revk/ESP32-EPD/PCB/EPD154/README.md

# Epaper154

These files are for use in [KiCad](https://www.kicad.org).

## Trademark

This is an open source project, but bear in mind you cannot sell boards bearing the Andrews & Arnold Ltd name, the A&A logo, the registered trademark AJK logo, or the GS1 allocated EANs assigned to Andrews & Arnold Ltd.

## Images

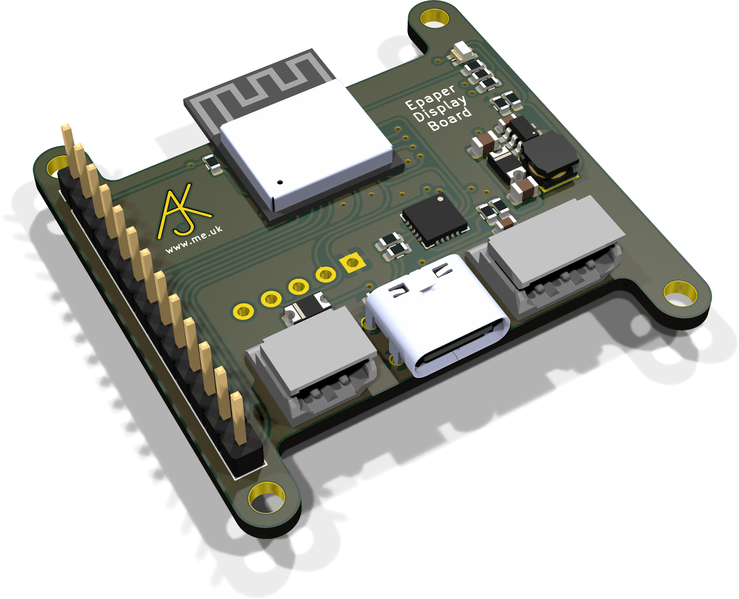
[picture p2: PCB/EPD154/Epaper154.png]
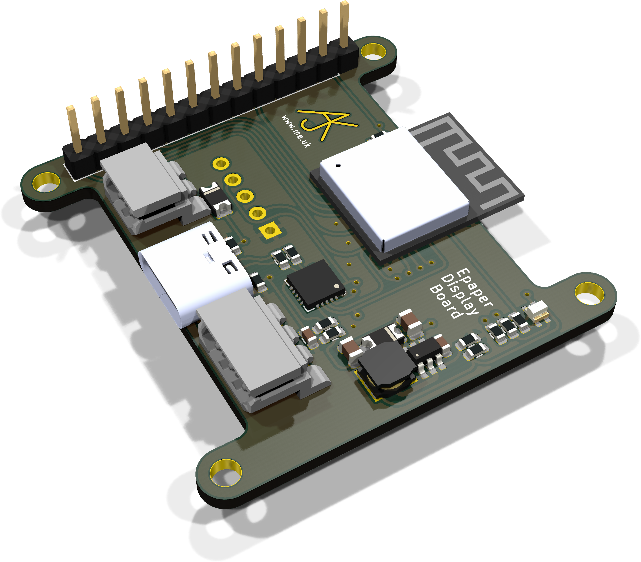
[picture p3: PCB/EPD154/Epaper154-90.png]
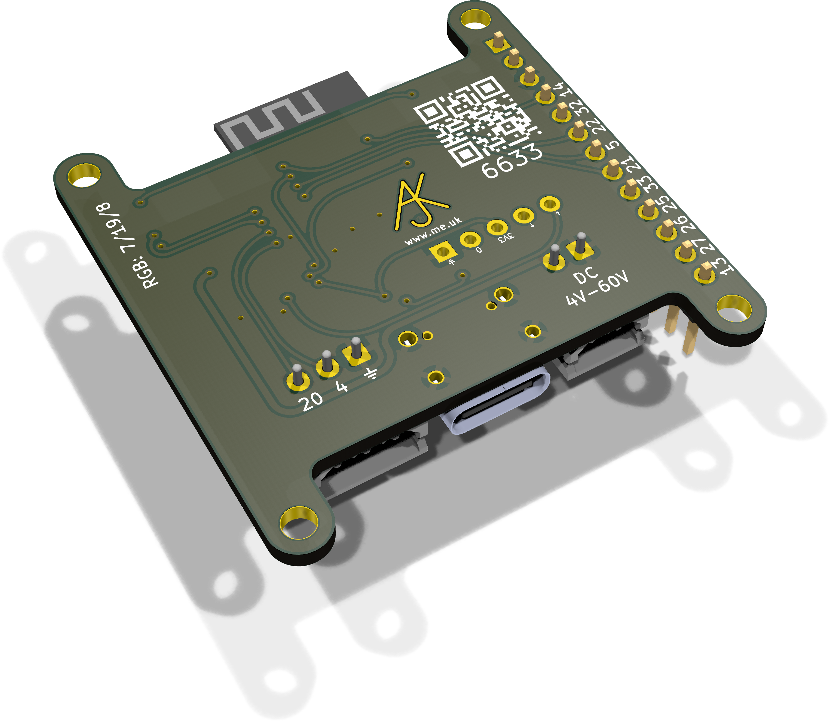
[picture p4: PCB/EPD154/Epaper154-bottom.png]
