revk/ESP32-EPD/PCB/EPD213/README.md

# Epaper213

These files are for use in [KiCad](https://www.kicad.org).

## Trademark

This is an open source project, but bear in mind you cannot sell boards bearing the Andrews & Arnold Ltd name, the A&A logo, the registered trademark AJK logo, or the GS1 allocated EANs assigned to Andrews & Arnold Ltd.

## Images

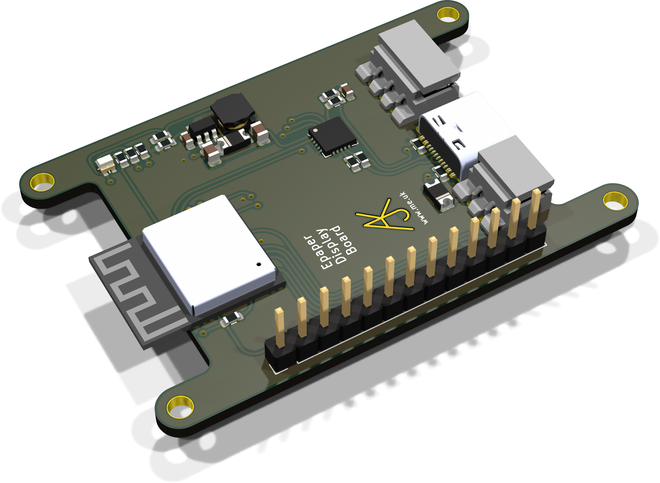
[picture p5: PCB/EPD213/Epaper213.png]
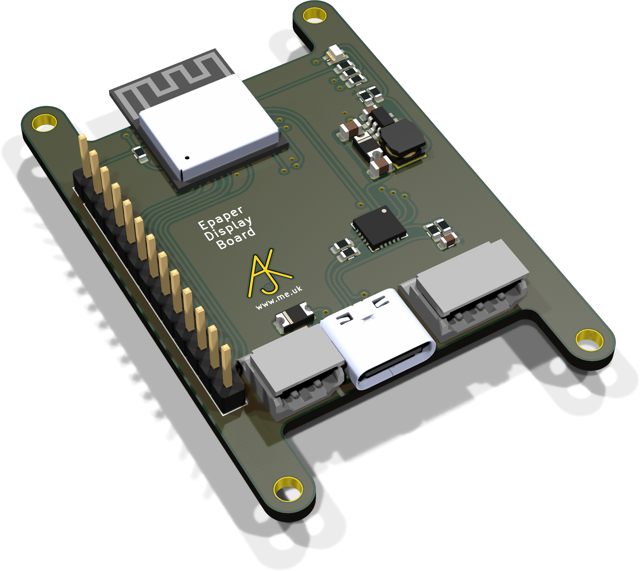
[picture p6: PCB/EPD213/Epaper213-90.png]
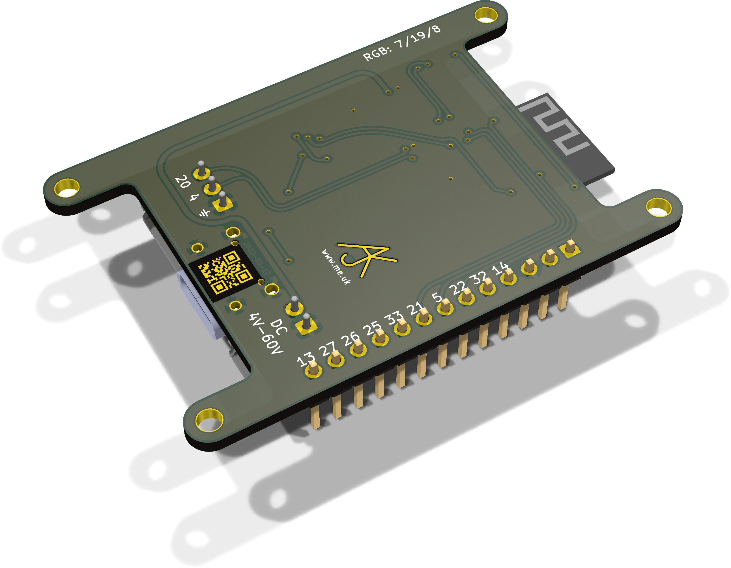
[picture p7: PCB/EPD213/Epaper213-bottom.png]
