revk/ESP32-EPD/PCB/EPD75/README.md

# EPD75

These files are for use in [KiCad](https://www.kicad.org).

## Trademark

This is an open source project, but bear in mind you cannot sell boards bearing the Andrews & Arnold Ltd name, the A&A logo, the registered trademark AJK logo, or the GS1 allocated EANs assigned to Andrews & Arnold Ltd.

## Images

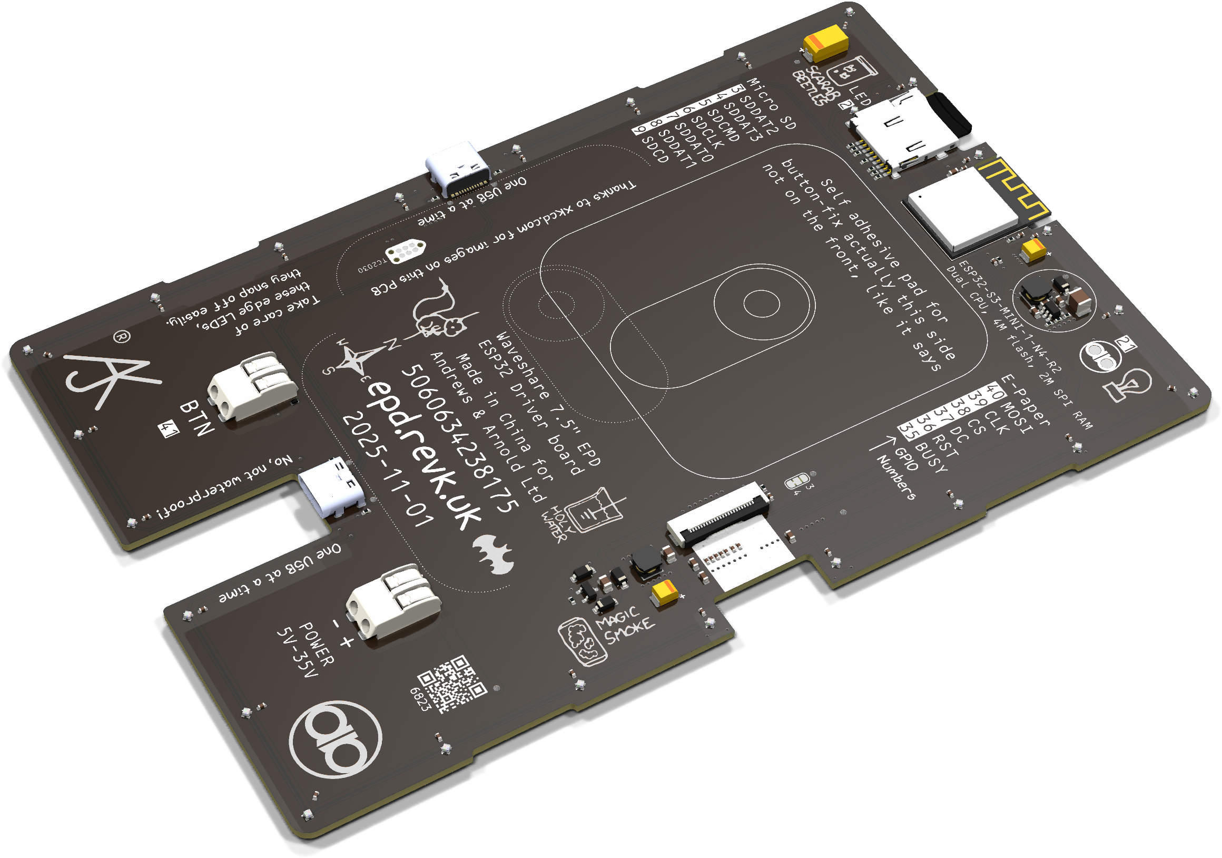
[picture p8: PCB/EPD75/EPD75-90.png]
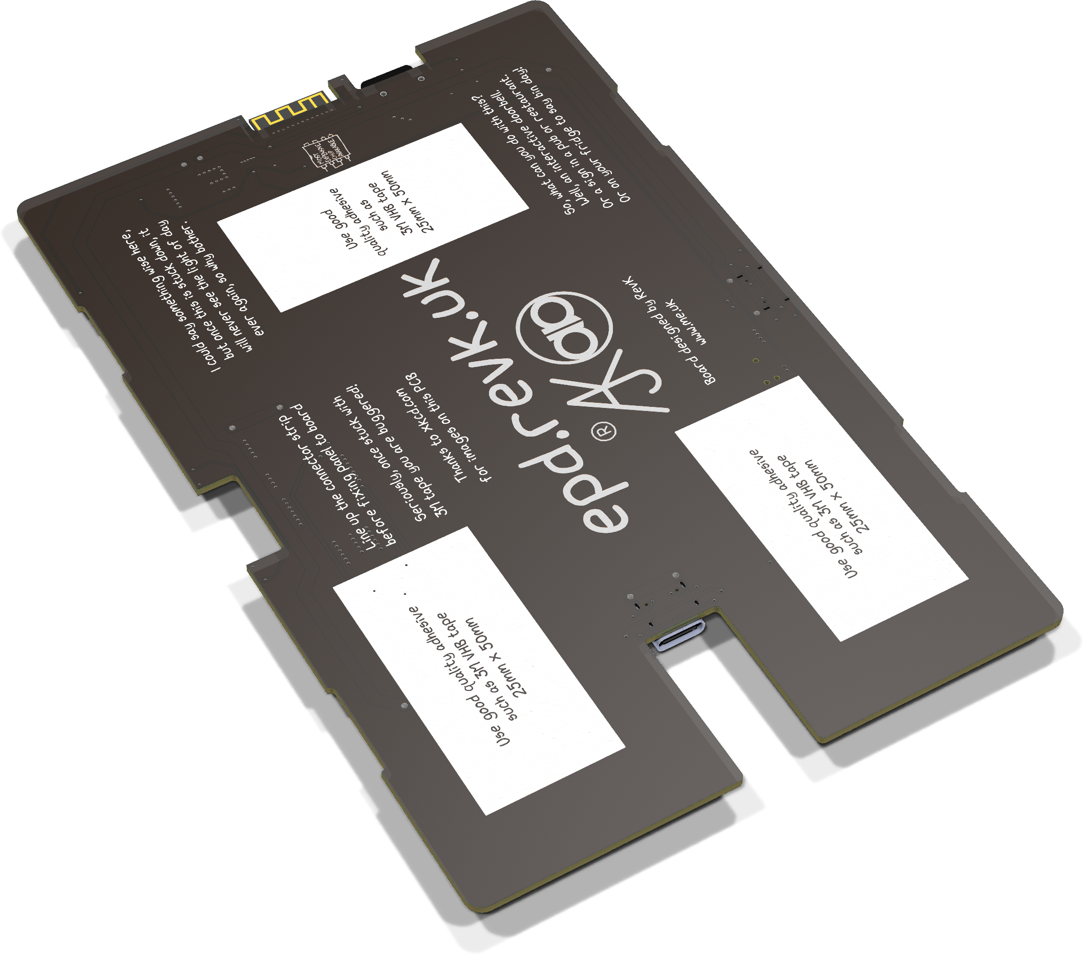
[picture p9: PCB/EPD75/EPD75-bottom.png]
