revk/ESP32-EPD/PCB/EPDBat/README.md

# EPDBat

These files are for use in [KiCad](https://www.kicad.org).

## Trademark

This is an open source project, but bear in mind you cannot sell boards bearing the Andrews & Arnold Ltd name, the A&A logo, the registered trademark AJK logo, or the GS1 allocated EANs assigned to Andrews & Arnold Ltd.

## Images

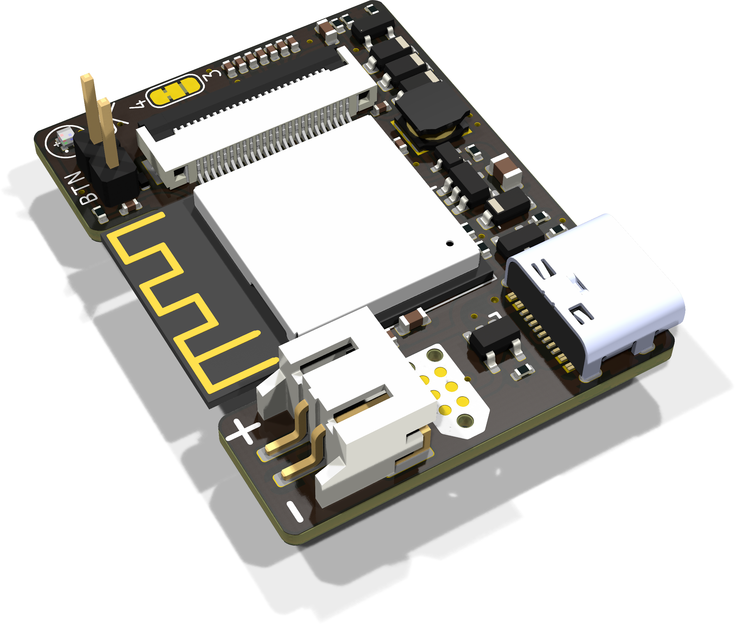
[picture p10: PCB/EPDBat/EPDBat.png]
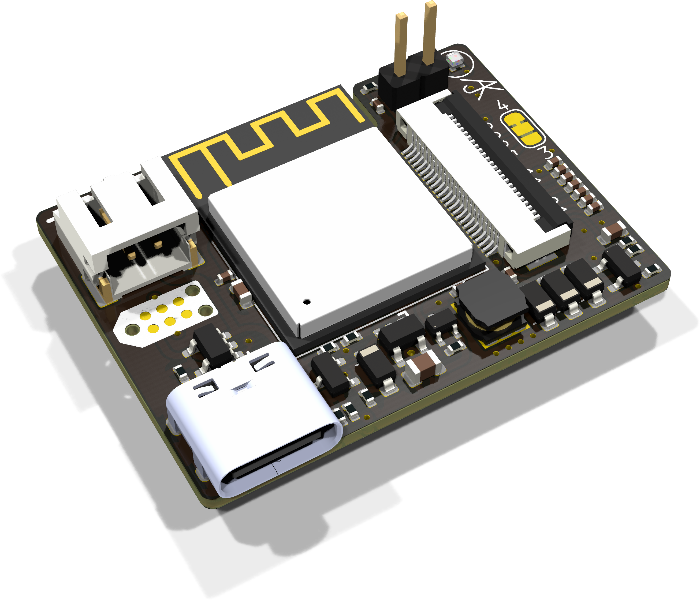
[picture p11: PCB/EPDBat/EPDBat-90.png]
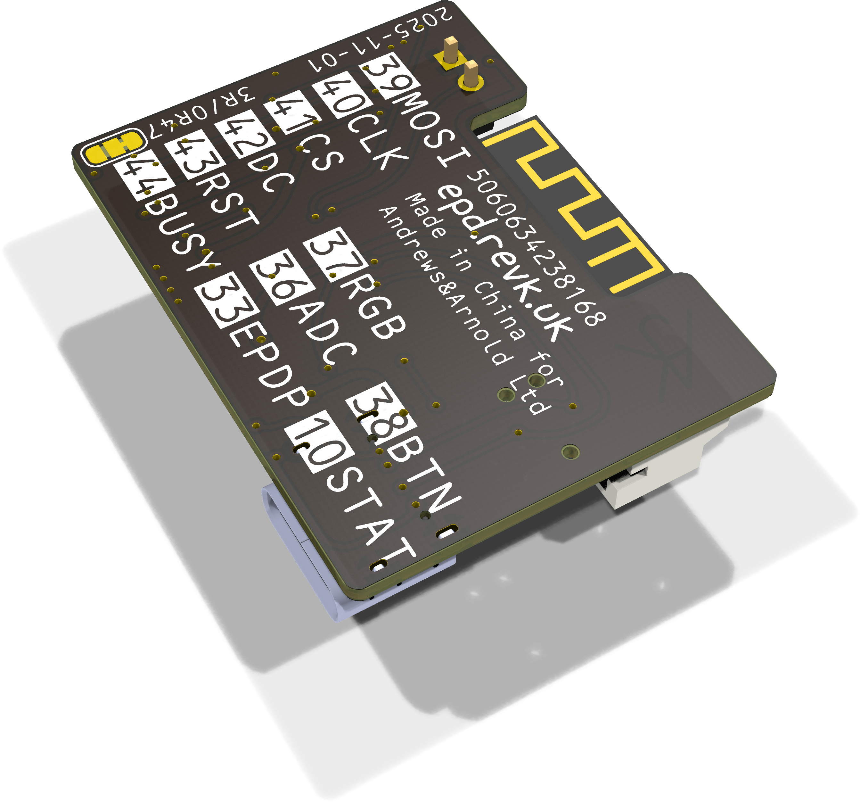
[picture p12: PCB/EPDBat/EPDBat-bottom.png]

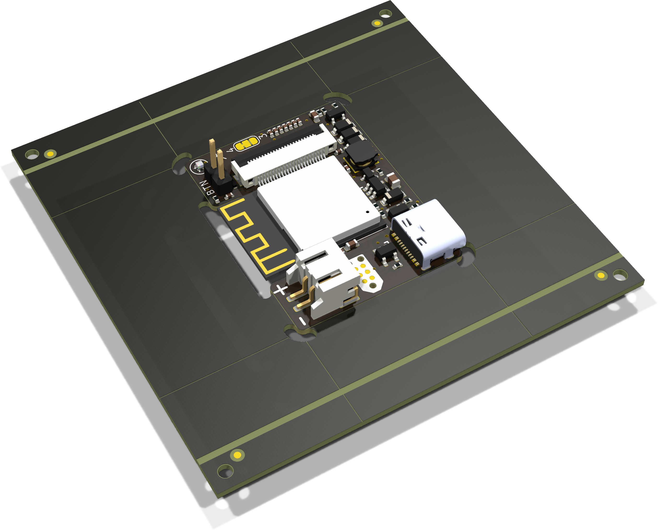
[picture p13: PCB/EPDBat/EPDBat-panel.png]
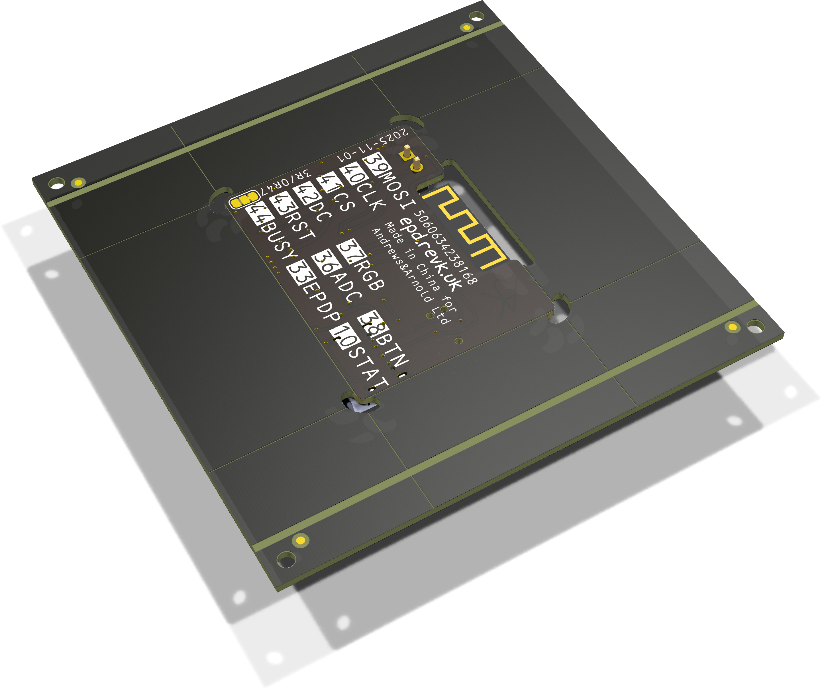
[picture p14: PCB/EPDBat/EPDBat-panel-bottom.png]
