revk/ESP32-EPD/PCB/EPD75NFC/EPD75-90.png

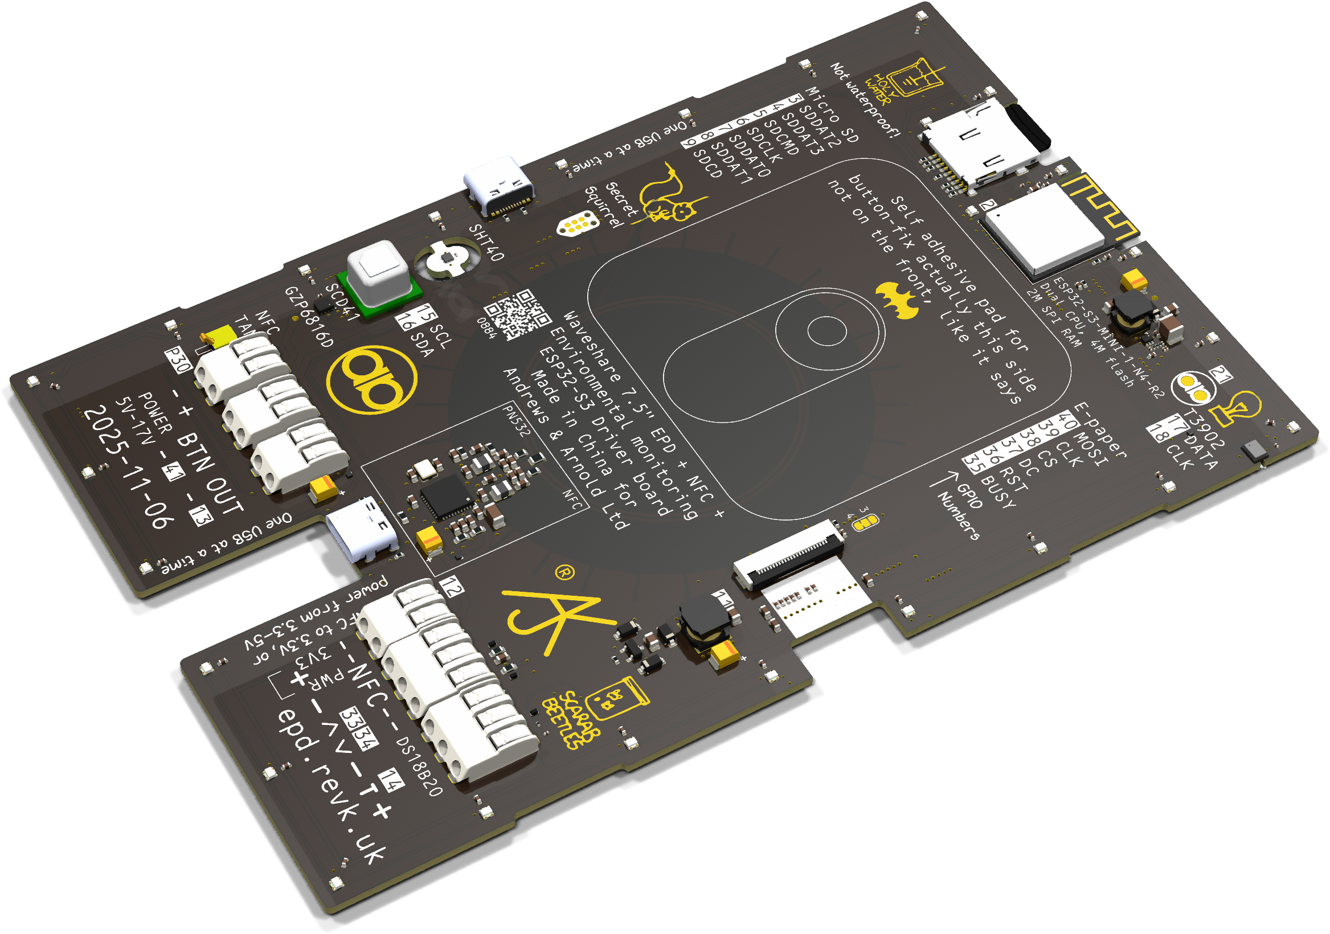
PCB/EPD75NFC/EPD75-90.png
