revk/ESP32-EPD/PCB/EPD75NFC/EPD75.png

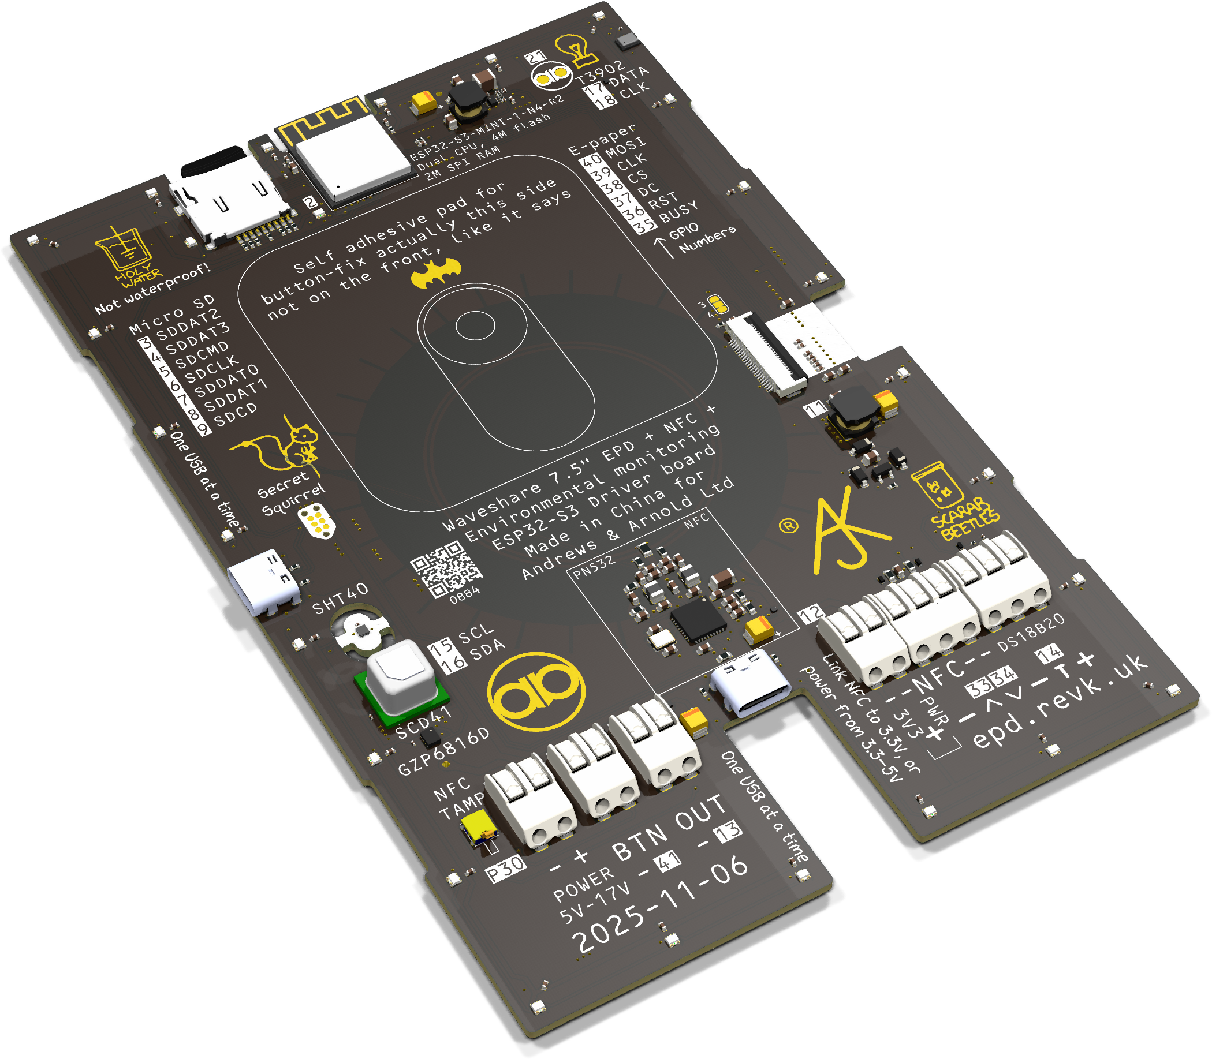
PCB/EPD75NFC/EPD75.png
