revk/ESP32-EPD/PCB/EPD/EPD-90.png

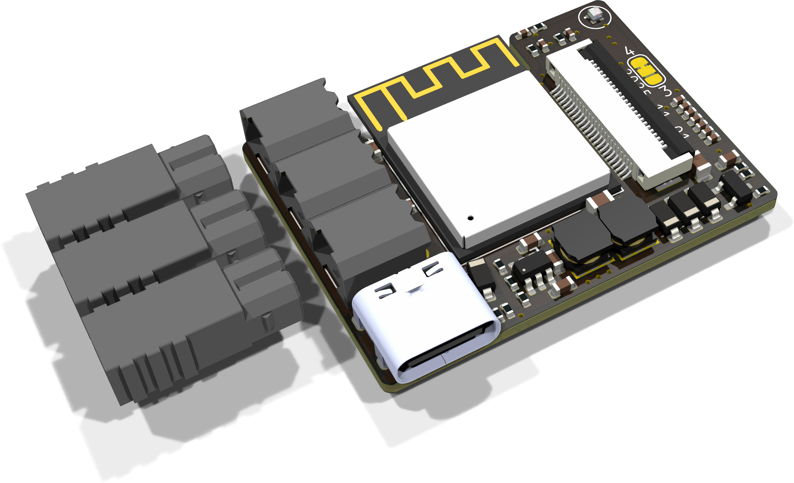
PCB/EPD/EPD-90.png
