revk/ESP32-EPD/PCB/EPD/EPD-bottom.png

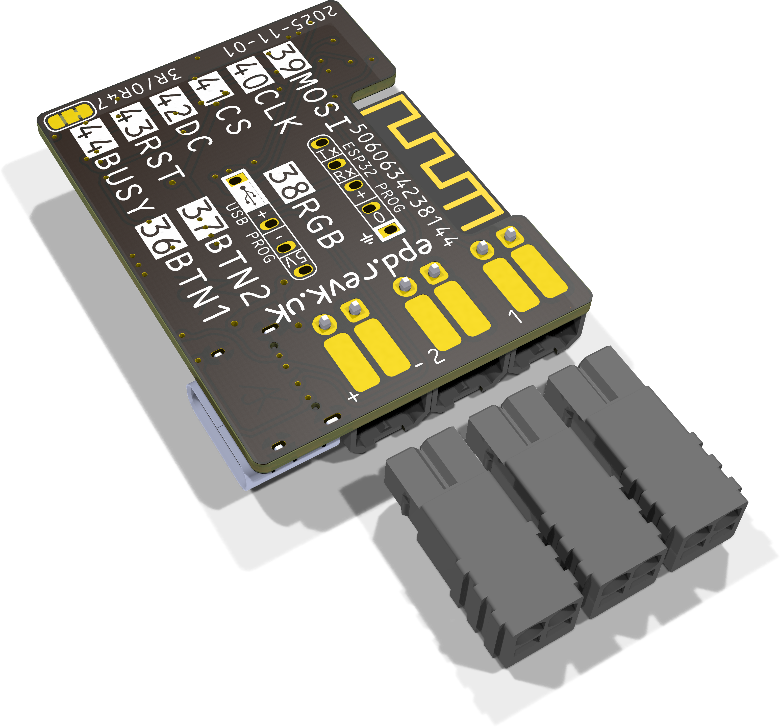
PCB/EPD/EPD-bottom.png
