revk/ESP32-EPD/PCB/EPD/EPD-panel-bottom.png

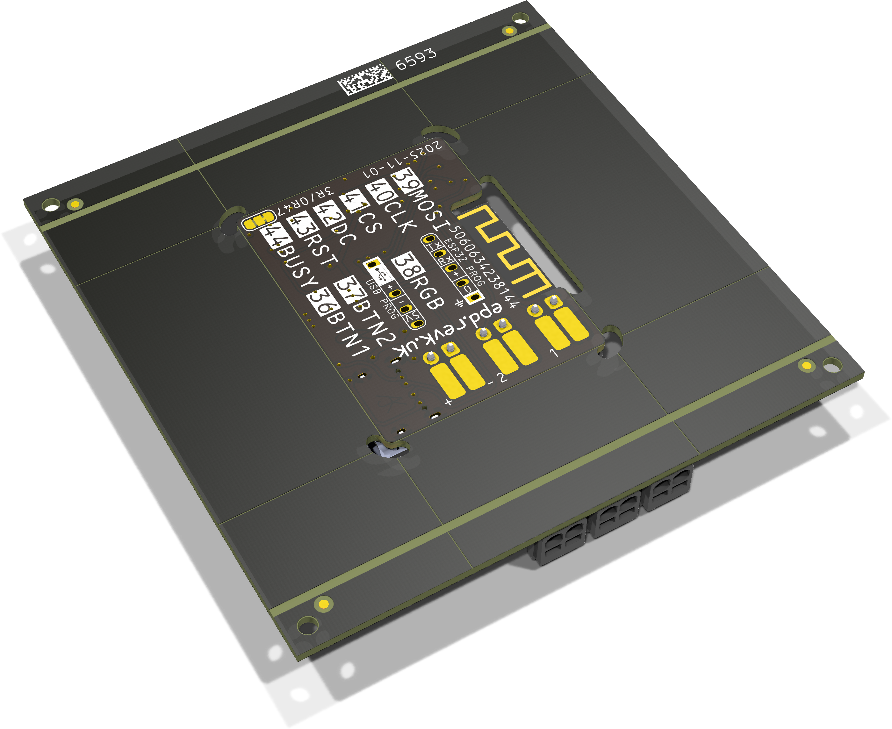
PCB/EPD/EPD-panel-bottom.png
