revk/ESP32-EPD/PCB/EPD/EPD-panel.png

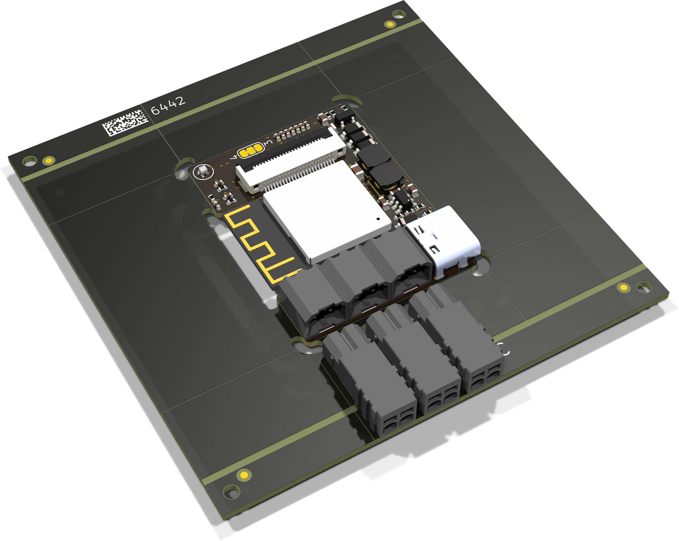
PCB/EPD/EPD-panel.png
