revk/ESP32-EPD/PCB/EPD/EPD.png

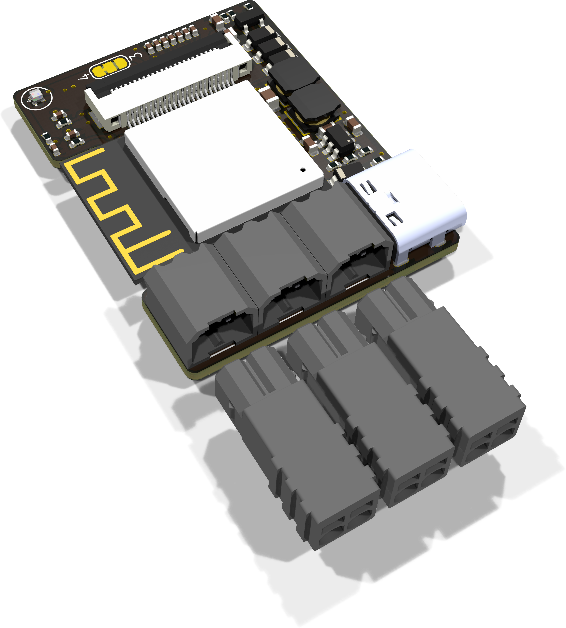
PCB/EPD/EPD.png
