revk/ESP32-EPD/PCB/EPD/EPD.stl

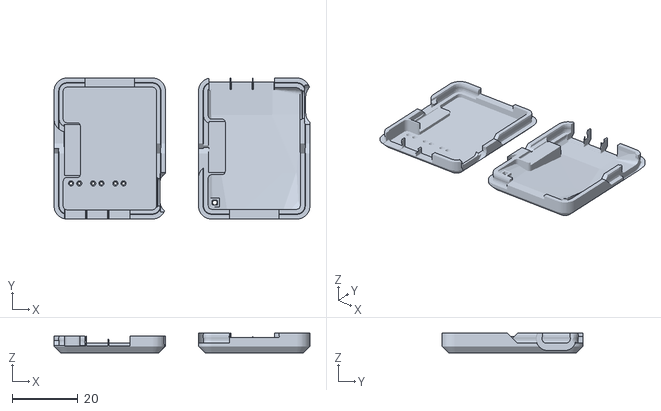
[picture p22: CAD file, 2025-11-01]
PCB/EPD/EPD.stl
78.0 x 43.0 x 5.99
