revk/ESP32-EPD/PCB/EPD75/Backbox.FCStd

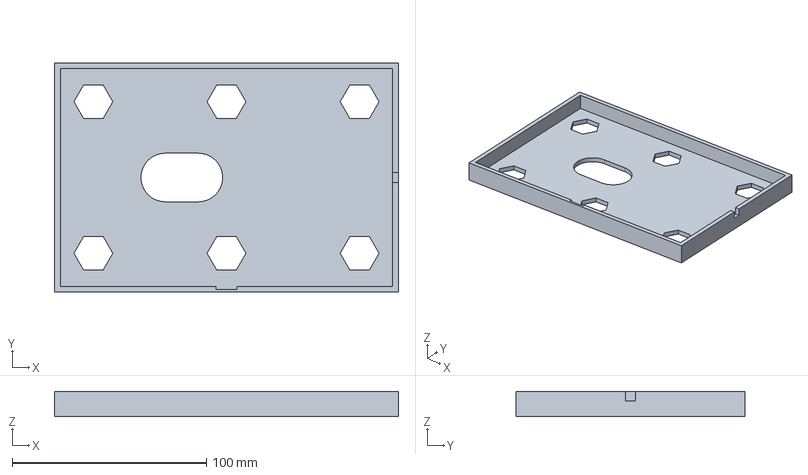
[picture p23: CAD file, 2025-03-20]
PCB/EPD75/Backbox.FCStd
177.0 x 118.0 x 13.0 mm
