revk/ESP32-EPD/PCB/EPDBat/EPDBat.stl

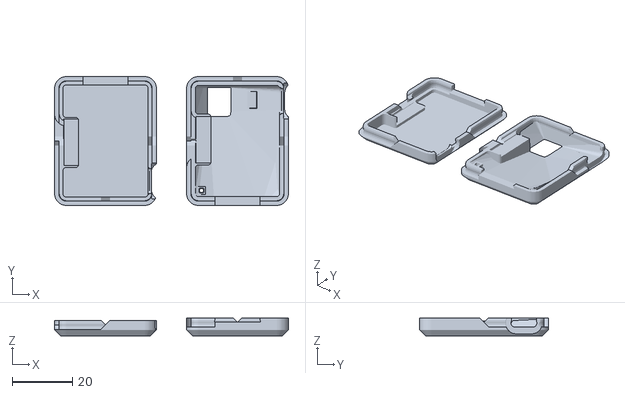
[picture p24: CAD file, 2025-11-01]
PCB/EPDBat/EPDBat.stl
78.0 x 43.0 x 5.99
