revk/ESP32-EPD/(list of files, cad)

Other CAD files:
PCB/EPD75/Backbox-BodyPocket002.stl
PCB/EPDBat/EPDBat.scad
