revk/ESP32-EPD/(threads)

Thread 1 (2025-03-01):

Ability to interact with mqtt

TonyHoyle, 2025-03-01:
It would be nice if you could set widgets using mqtt, then I could feed it mqtt data from things like homeassistant.   It would seem to be sensible to do it publishing a setting eg. settings/F0F5BD731DF8 {"widgetc3":"foo"}

revk, 2025-03-01:
Err, all widget settings can be done via MQTT just like that, what am I missing?

TonyHoyle, 2025-03-01:
I tried and nothing happens.  Normal commands like reboot work.  If it's supposed to work already I'll keep trying things, maybe doing something wrong.

(Another thing I discovered just now that the $IPV4 command always shows 192.168.4.1, which isn't even the same subnet that it's sitting on.. (it's actually on 	192.168.10.151)).

revk, 2025-03-01:
Ok I'll look in morning

revk, 2025-03-01:
oooh wait, `setting` or `settings`?

TonyHoyle, 2025-03-01:
Oh that may be it..

TonyHoyle, 2025-03-02:
Got it working.. seems pretty responsive.

At the risk of overloading this ssue still further, Is landscape mode possible?  I tried flipping the bit in gfxflip but it stopped it displaying anything at all..

revk, 2025-03-02:
Gfxflip should allow landscape, but not tested for a while. I'll have to check.

I am still trying to make the fast update better contrast. Been battling all week.

revk, 2025-03-02:
Just tried here, and nothing shows, so will test and fix when not at the pub.

Bit 2 (value 4) is x/y swap. Set for portrait as panel is actually 800x480. So flips OK, just does not unflip!!!

revk, 2025-03-02:
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

Ok fixed it whilst at the pub. The GFX code was fine. The EPD code was trying to plot a QR on remaining space on the startup page that was 4.2 billion pixels high ish. So would, one day, have shown something.

Try latest beta.

TonyHoyle, 2025-03-02:
That would be need pretty high resolution display 📦

TonyHoyle, 2025-03-02:
Heh.. lost all the positioning information when I upgraded.. but since I was going to switch to landscape anyway, no loss I guess.  Seems to work so far.

revk, 2025-03-02:
Yeh, sorry, my bad on that.

Glad it is working.

revk, 2025-03-27:
Ok new features since, hope all is OK.

Did you see https://www.revk.uk/2025/03/more-on-e-paper.html ? If you want me to send a 470uH inductor, let me know.

TonyHoyle, 2025-03-27:
I could probably use one.. my screen looks fairly ropey after I rearranged the output and all the old positions stuck.

revk, 2025-03-28:
I'll post you one - slightly fiddly to replace - don't heat hun your panel! It is the inductor near the e-paper connector (by a bat probably).

Closed 2025-03-27.

Thread 3 (2025-06-05):

Can't get bins widget to show individual collection info

jshholland, 2025-06-05:
I've been trying to set up the bin widget to show collections for my local council. I wrote some code to scrape their website (stealing the flow from the [UKBinCollectionData](https://github.com/robbrad/UKBinCollectionData/) repo) and reformat it to how the display expects to receive it. It's clearly partially working, as I can see requests arriving and it shows the correct day on the screen, but I can't get it to show which bins are due to be collected:

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

I've tried a few different formats for the response (and it initially caught me out that putting `http://ip:port/api/bins` into the URL textarea resulted in requests to `/api/bins.json`) but none have worked. I even got as far as hardcoding the sample JSON from the readme as the response, but that has the same (lack of) effect.

Here's what my code response looks like:

```json
{"collect":"2025-06-10 07:00:00","baseurl":"http://<ip>:4000","bins":[{"name":"Domestic Waste","icon":"/general.png"}]}
```

It's definitely doing something to parse the "bins" field as when I was testing it I got it to turn on the LED that way (although I don't want to use the LEDs for this once it's working properly). It is also sometimes showing the "name" field but I haven't been able to work out what is and isn't working.

I've tried: icon as `general.png`, `/general.png`, `http://<ip>:4000/general.png`, `/general`, with and without the `collect` field, and with and without a final `{}`.

I'd also be keen to get tips for how to debug this a bit more easily than changing random things and rebooting it to see what appears on the screen - I tried messing around with platformio but it seems like serious overkill just to see some of the ESP_LOGD outputs, but I really am not an expert on this sort of embedded development.

revk, 2025-06-06:
The way to get debug is installing ESP IDF and running `idf.py monitor` on the USB port, that should help show if issues accessing PNG URLs, etc. I could add some levels of additional MQTT logging.

I'll see if I can test using ip:port format, but I would expect that to work to be honest.

revk, 2025-06-06:
OK, weird...

I am getting

```
E (15490) esp-tls: [sock=60] delayed connect error: Connection reset by peer
E (15491) transport_base: Failed to open a new connection: 32772
E (15494) HTTP_CLIENT: Connection failed, sock < 0
E (15499) EPD: Failed http client open http://91.240.176.1:4000//general.png
```

Which suggests that it is trying TLS?! Looking in to it.

revk, 2025-06-06:
OK the TLS may be a red herring, it *is* trying to get to port 4000. So let me try serving something.

Now I see

```
E (15381) EPD: Unknown http://91.240.176.252:4000/general.png error Not a PNG Bad JSON
```

With my apache confirming it responded 404.

So I have actually set up a png, and served that and it shows.

Maybe check your server logs?

I removed the initial `/` from the icon, but my apache serves fine with it present.

jshholland, 2025-06-06:
It's nothing fancy, just something from Flaticons.com that I resized with ImageMagick. But here it is:

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

Also uploaded to [0x0.st](https://0x0.st/8gMh.png) in case GitHub mangles it somehow

jshholland, 2025-06-06:
Huh, why does it show up OK with the image widget then? Does that have some auto-invert logic?

jshholland, 2025-06-06:
Great, now I have an image that displays properly I am happy it's all working! Thanks a lot.

revk, 2025-06-06:
Thanks, sorry for confusion, and not the explanation I expected...

Closed 2025-06-06.
