revk/ESP32-EPD/PCB/EPD75/EPD75.kicad_pcb

## KiCad design PCB/EPD75/EPD75.kicad_pcb (2025-09-28)

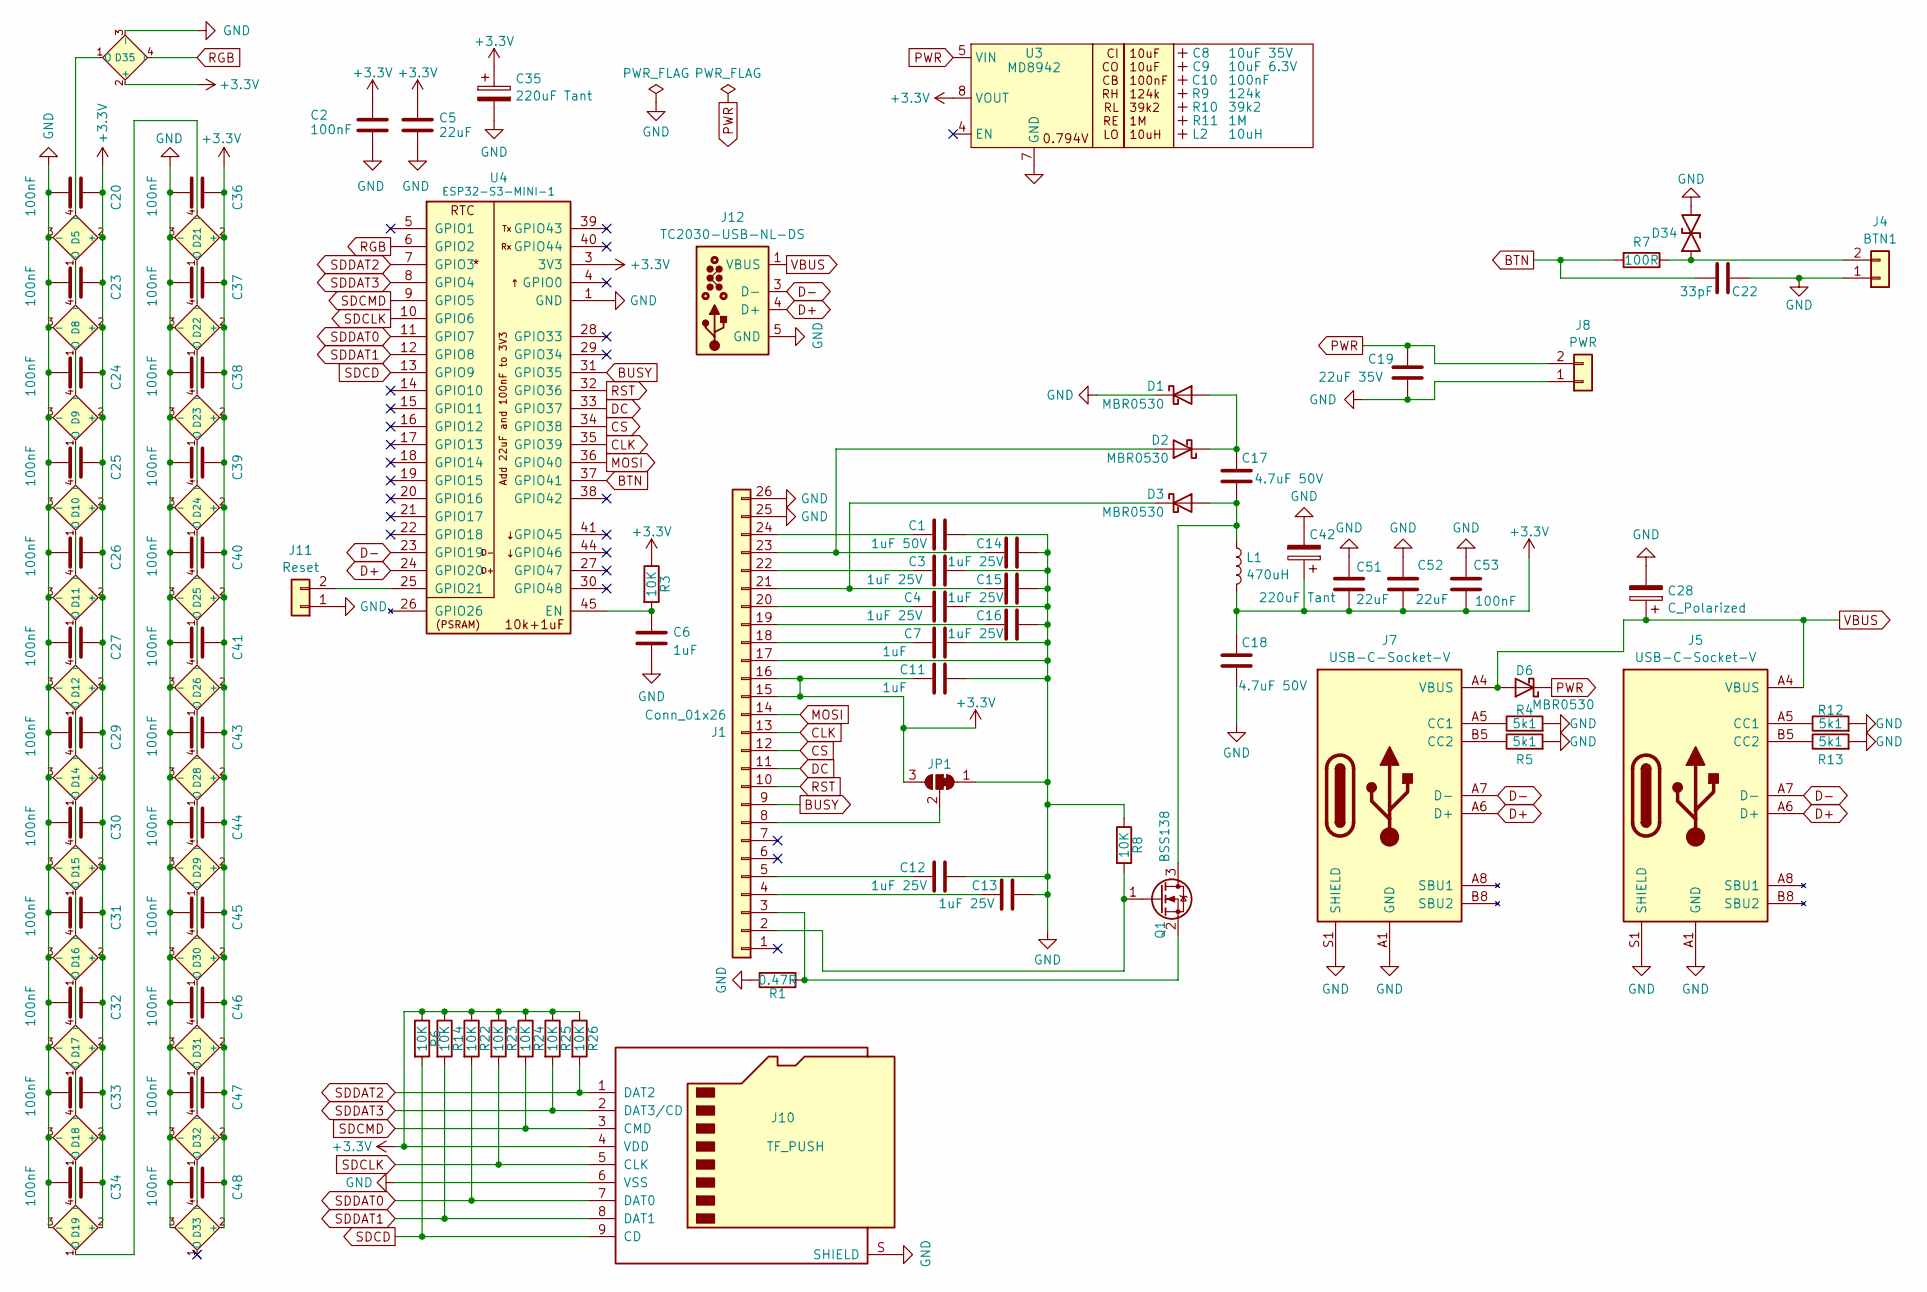
[picture p25: schematic EPD75.kicad_sch, E-Paper 7.5"]

Parts:
C1: 1uF 50V; C_0603
C2, C20, C23, C24, C25, C26, C27, C29, C30, C31, C32, C33, C34, C36, C37, C38, C39, C40, C41, C43, C44, C45, C46, C47, C48, C53: 100nF; C_0402
C3, C4, C12, C13, C14, C15, C16: 1uF 25V; C_0402
C5, C51, C52: 22uF; C_0603
C6, C7, C11: 1uF; C_0402
C8: 10uF 35V; C_0603_; MPN C194427
C9: 10uF 6.3V; C_0603_; MPN C1691
C10: 100nF; C_0603_
C17, C18: 4.7uF 50V; C_0805
C19: 22uF 35V; C_1210
C22: 33pF; C_0402
C28: C_Polarized; CP_EIA-7343-31_Kemet-D; MPN C106188
C35, C42: 220uF Tant; CP_EIA-3528-21_Kemet-B; MPN C122649
D1, D2, D3, D6: MBR0530; D_SOD-123; MPN C5204746
D5, D8, D9, D10, D11, D12, D14, D15, D16, D17, D18, D19, D21, D22, D23, D24, D25, D26, D28, D29, D30, D31, D32, D33, D35: XL-1010RGBC-WS2812B; MPN C5349953
D34: DFN1006-2L; MPN C5137770
J1: Conn_01x26; XUNPU-FPC-05FB-24PH20; MPN C2856831
J4: BTN1; WAGO-2060-452-998-404; MPN C2765055
J5, J7: USB-C-Socket-V; USB-C-Socket-H; MPN C709357
J8: PWR; WAGO-2060-452-998-404; MPN C2765055
J10: TF_PUSH; MPN C393941
J11: Reset; AA-Pad
J12: TC2030-USB-NL-DS; Tag-Connect_TC2030-IDC-NL_2x03_P1.27mm_Vertical
JP1: SolderJumper_3_Bridged12; SolderJumper3
L1: 470uH; L_4x4; MPN C42429207
L2: 10uH; L_4x4_; MPN C167879
Q1: BSS138; SOT-23; MPN C2938375
R1: 0.47R; R_0402; MPN C2771738
R3, R6, R8, R14, R22, R23, R24, R25, R26: 10K; R_0402
R4, R5, R12, R13: 5k1; R_0402
R7: 100R; R_0402
R9: 124k; R_0402_; MPN C138062
R10: 39k2; R_0402_
R11: 1M; R_0402_
U3: MD8942; SOT-23-6-MD8942; MPN C2684786
U4: ESP32-S3-MINI-1; MPN C3013941

Connections:
+3.3V: C2.1, C5.1, C11.1, C18.2, C20.1, C23.1, C24.1, C25.1, C26.1, C27.1, C29.1, C30.1, C31.1, C32.1, C33.1, C34.1, C35.1, C36.1, C37.1, C38.1, C39.1, C40.1, C41.1, C42.1, C43.1, C44.1, C45.1, C46.1, C47.1, C48.1, C51.2, C52.2, C53.2, D5.2 (+), D8.2 (+), D9.2 (+), D10.2 (+), D11.2 (+), D12.2 (+), D14.2 (+), D15.2 (+), D16.2 (+), D17.2 (+), D18.2 (+), D19.2 (+), D21.2 (+), D22.2 (+), D23.2 (+), D24.2 (+), D25.2 (+), D26.2 (+), D28.2 (+), D29.2 (+), D30.2 (+), D31.2 (+), D32.2 (+), D33.2 (+), D35.2 (+), J1.15, J1.16, J10.4 (VDD), JP1.3 (B), L1.2, R3.1, R6.1, R14.1, R22.1, R23.1, R24.1, R25.1, R26.1, U3.8 (VOUT), U4.3 (3V3)
BTN: C22.1, R7.2, U4.37 (GPIO41)
BUSY: J1.9, U4.31 (GPIO35)
CLK: J1.13, U4.35 (GPIO39)
CS: J1.12, U4.34 (GPIO38)
D+: J5.A6 (D+), J5.B6 (D+), J7.A6 (D+), J7.B6 (D+), J12.4 (D+), U4.24 (GPIO20)
D-: J5.A7 (D-), J5.B7 (D-), J7.A7 (D-), J7.B7 (D-), J12.2 (NC), J12.3 (D-), J12.6 (NC), U4.23 (GPIO19)
DC: J1.11, U4.33 (GPIO37)
GND: C1.2, C2.2, C3.2, C4.2, C5.2, C6.2, C7.2, C11.2, C12.2, C14.2, C15.2, C18.1, C19.2, C20.2, C22.2, C23.2, C24.2, C25.2, C26.2, C27.2, C28.2, C29.2, C30.2, C31.2, C32.2, C33.2, C34.2, C35.2, C36.2, C37.2, C38.2, C39.2, C40.2, C41.2, C42.2, C43.2, C44.2, C45.2, C46.2, C47.2, C48.2, C51.1, C52.1, C53.1, D1.1 (K), D5.3 (-), D8.3 (-), D9.3 (-), D10.3 (-), D11.3 (-), D12.3 (-), D14.3 (-), D15.3 (-), D16.3 (-), D17.3 (-), D18.3 (-), D19.3 (-), D21.3 (-), D22.3 (-), D23.3 (-), D24.3 (-), D25.3 (-), D26.3 (-), D28.3 (-), D29.3 (-), D30.3 (-), D31.3 (-), D32.3 (-), D33.3 (-), D34.1, D35.3 (-), J1.17, J1.25, J1.26, J4.1, J5.A1 (GND), J5.A12 (GND), J5.B1 (GND), J5.B12 (GND), J5.S1 (SHIELD), J7.A1 (GND), J7.A12 (GND), J7.B1 (GND), J7.B12 (GND), J7.S1 (SHIELD), J8.1, J10.6 (VSS), J10.S (SHIELD), J11.1, J12.5 (GND), JP1.1 (A), R1.2, R4.2, R5.2, R8.1, R12.2, R13.2, U3.2 (GND), U3.7 (GND), U4.1 (GND), U4.2 (GND), U4.42 (GND), U4.43 (GND), U4.46 (GND), U4.47 (GND), U4.48 (GND), U4.49 (GND), U4.50 (GND), U4.51 (GND), U4.52 (GND), U4.53 (GND), U4.54 (GND), U4.55 (GND), U4.56 (GND), U4.57 (GND), U4.58 (GND), U4.59 (GND), U4.60 (GND), U4.61 (GND), U4.62 (GND), U4.63 (GND), U4.64 (GND), U4.65 (GND)
MOSI: J1.14, U4.36 (GPIO40)
unnamed: C17.2, D1.2 (A), D2.1 (K)
unnamed: C14.1, D2.2 (A), J1.23
unnamed: C17.1, D3.2 (A), L1.1, Q1.3 (D)
unnamed: C15.1, D3.1 (K), J1.21
unnamed: D5.1 (O), D8.4 (I)
unnamed: D8.1 (O), D9.4 (I)
unnamed: D9.1 (O), D10.4 (I)
unnamed: D10.1 (O), D11.4 (I)
unnamed: D11.1 (O), D12.4 (I)
unnamed: D12.1 (O), D14.4 (I)
unnamed: D14.1 (O), D15.4 (I)
unnamed: D15.1 (O), D16.4 (I)
unnamed: D16.1 (O), D17.4 (I)
unnamed: D17.1 (O), D18.4 (I)
unnamed: D18.1 (O), D19.4 (I)
unnamed: D19.1 (O), D21.4 (I)
unnamed: D21.1 (O), D22.4 (I)
unnamed: D22.1 (O), D23.4 (I)
unnamed: D23.1 (O), D24.4 (I)
unnamed: D24.1 (O), D25.4 (I)
unnamed: D25.1 (O), D26.4 (I)
unnamed: D26.1 (O), D28.4 (I)
unnamed: D28.1 (O), D29.4 (I)
unnamed: D29.1 (O), D30.4 (I)
unnamed: D30.1 (O), D31.4 (I)
unnamed: D31.1 (O), D32.4 (I)
unnamed: D32.1 (O), D33.4 (I)
unnamed: D5.4 (I), D35.1 (O)
unnamed: J1.2, Q1.1 (G), R8.2
unnamed: J1.3, Q1.2 (S), R1.1
unnamed: C12.1, J1.5
unnamed: J1.8, JP1.2 (C)
unnamed: C7.1, J1.18
unnamed: C4.1, J1.20
unnamed: C1.1, J1.24
unnamed: D34.2, J4.2, R7.1
unnamed: J5.A5 (CC1), R12.1
unnamed: J5.B5 (CC2), R13.1
unnamed: J7.A5 (CC1), R4.1
unnamed: J7.B5 (CC2), R5.1
unnamed: J11.2, U4.25 (GPIO21)
unnamed: C6.1, R3.2, U4.45 (EN)
PWR: C19.1, D6.1 (K), J8.2, U3.5 (VIN)
RGB: D35.4 (I), U4.6 (GPIO2)
RST: J1.10, U4.32 (GPIO36)
SDCD: J10.9 (CD), R6.2, U4.13 (GPIO9)
SDCLK: J10.5 (CLK), R23.2, U4.10 (GPIO6)
SDCMD: J10.3 (CMD), R24.2, U4.9 (GPIO5)
SDDAT0: J10.7 (DAT0), R22.2, U4.11 (GPIO7)
SDDAT1: J10.8 (DAT1), R14.2, U4.12 (GPIO8)
SDDAT2: J10.1 (DAT2), R26.2, U4.7 (GPIO3)
SDDAT3: J10.2 (DAT3/CD), R25.2, U4.8 (GPIO4)
VBUS: C28.1, D6.2 (A), J5.A4 (VBUS), J5.A9 (VBUS), J5.B4 (VBUS), J5.B9 (VBUS), J7.A4 (VBUS), J7.A9 (VBUS), J7.B4 (VBUS), J7.B9 (VBUS), J12.1 (VBUS)

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
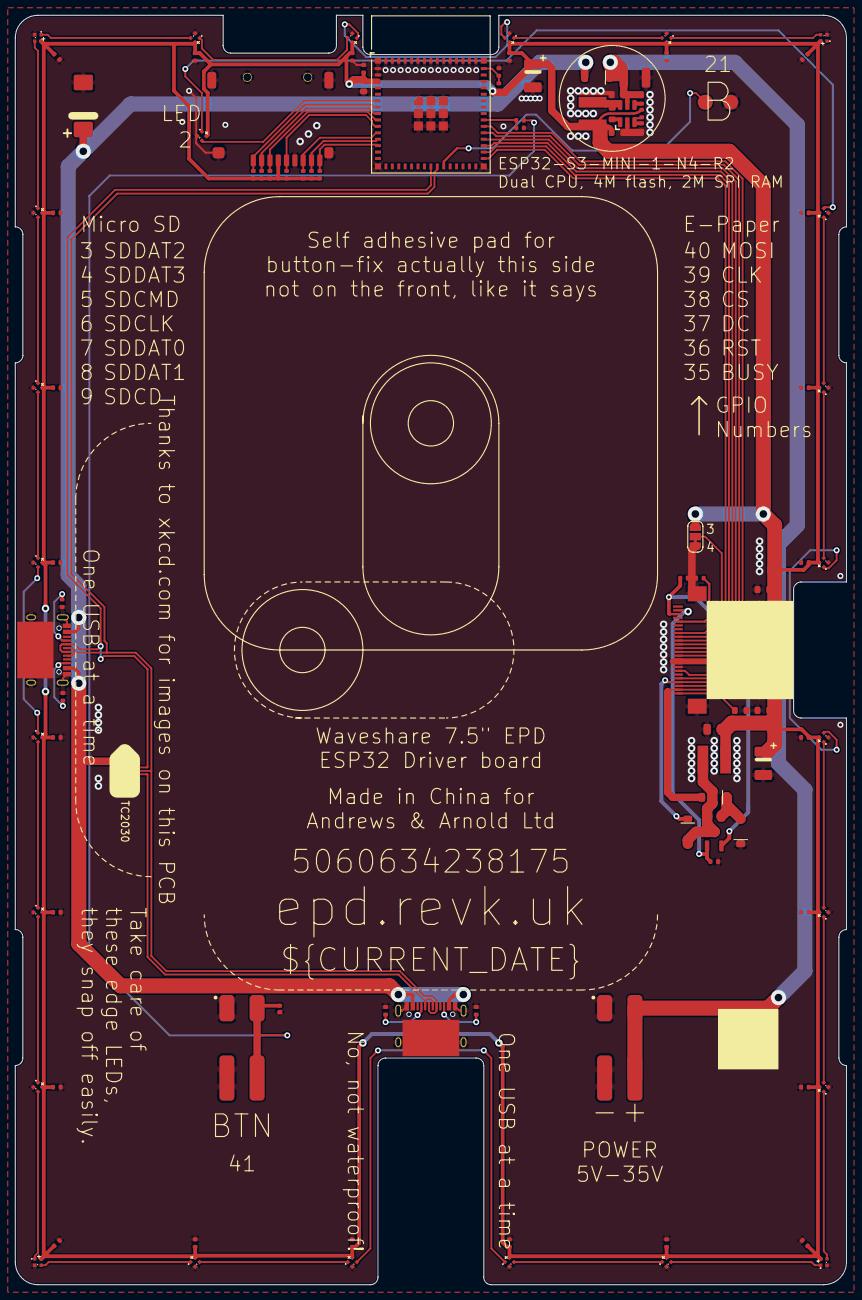
[picture p26: board EPD75.kicad_pcb from above]

Board: 2 copper layers, 110.0 x 168.0 mm, 110 parts (0 on the bottom side), 64 nets.
