revk/ESP32-EPD/PCB/EPD/EPD.kicad_pcb

## KiCad design PCB/EPD/EPD.kicad_pcb (2025-03-25)

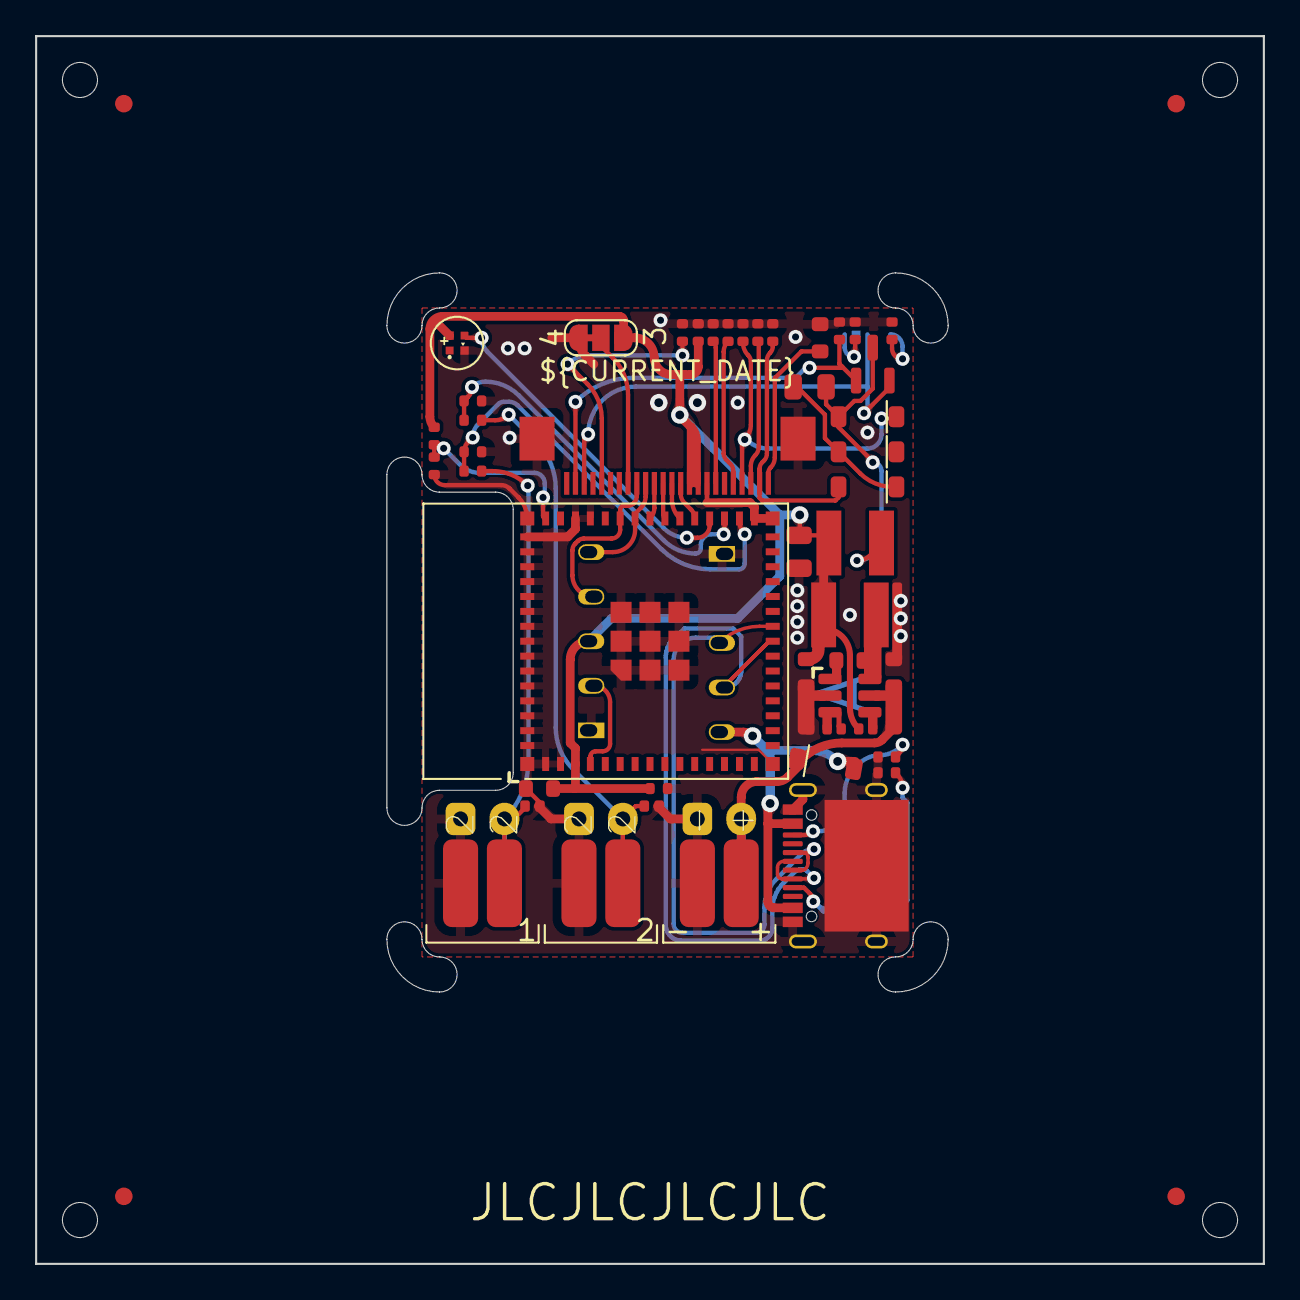
[picture p27: board EPD.kicad_pcb from above]

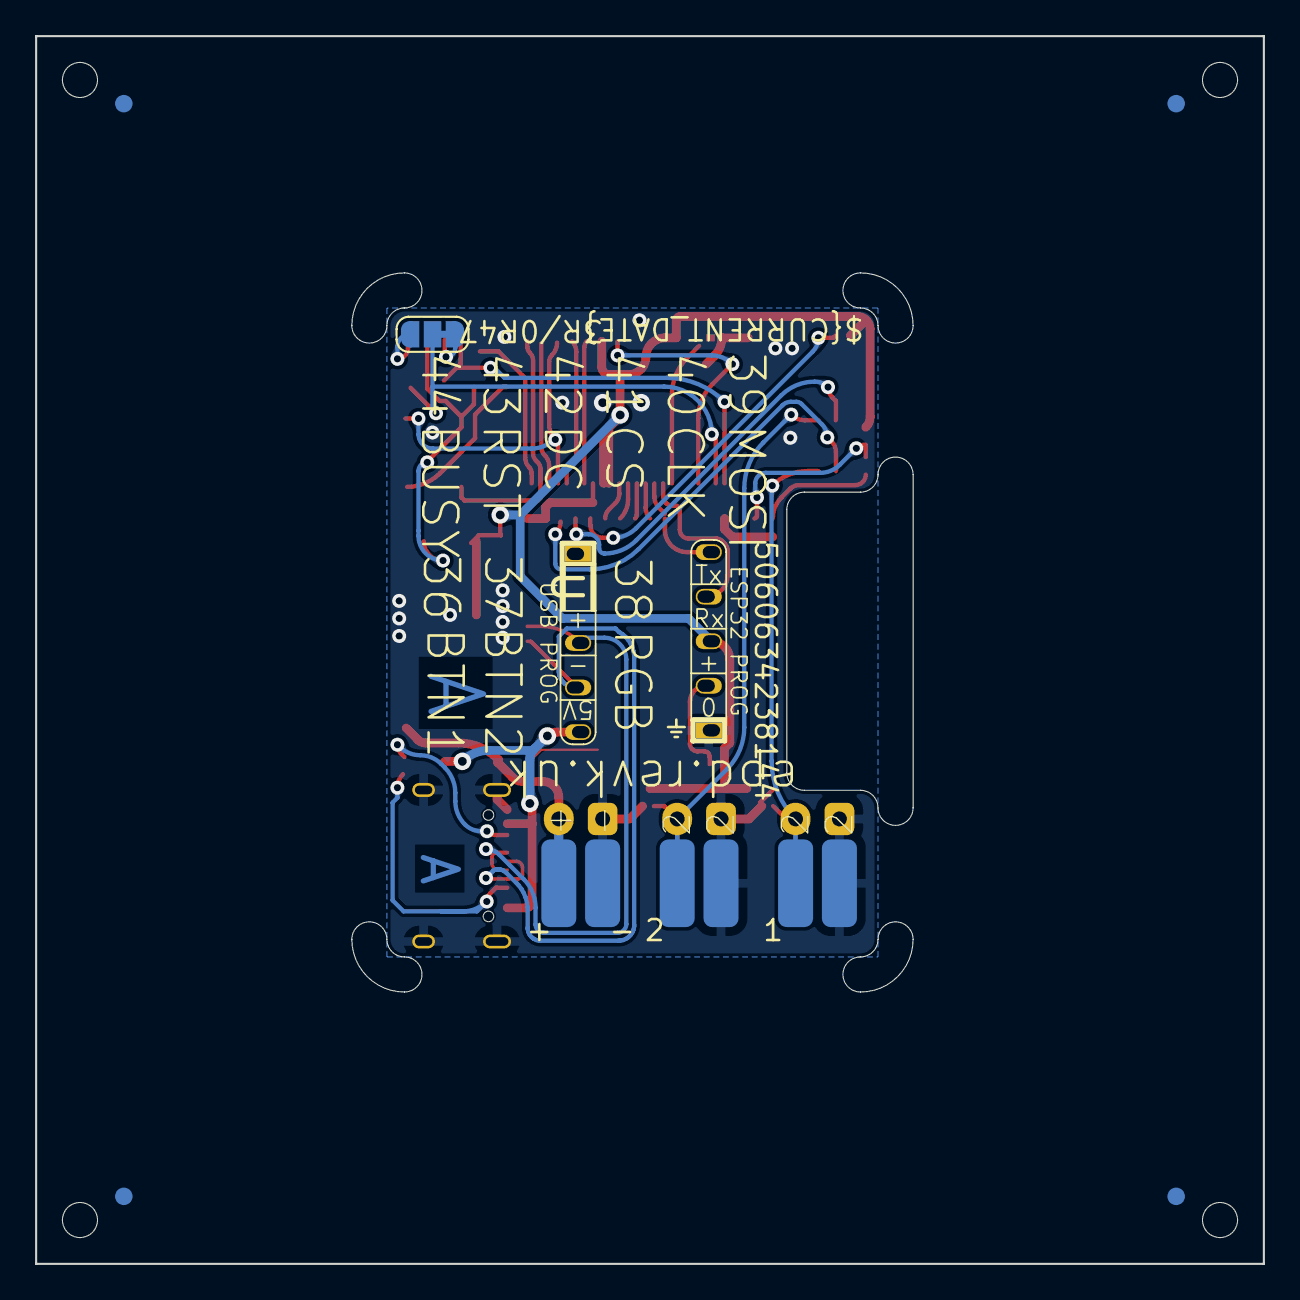
[picture p28: board EPD.kicad_pcb from below]

Board: 2 copper layers, 70.0 x 70.0 mm, 67 parts (11 on the bottom side), 35 nets.

Parts:
C1: 1uF 50V; C_0603
C2: 100nF; C_0402
C3, C4, C12, C14, C15: 1uF 25V; C_0402
C5: 22uF; C_0603
C6, C7, C11: 1uF; C_0402
C8: 10uF 35V; C_0603_
C9: 10uF 6.3V; C_0603_
C10: 100nF; C_0603_
C17, C18: 4.7uF 50V; C_0805
C19, C21: 33pF; C_0402
D1, D2, D3, D6: MBR0530; D_SOD-123
D4: XL-1010RGBC-WS2812B; SMD1010
D5, D7: DFN1006-2L
J1: Conn_01x26; XUNPU-FPC-05FB-24PH20
J2: Shelly
J3: USB-PROG
J4, J6: BTN2; PTSM-HH-2-RA
J7: USB-C-Socket-V; USB-C-Socket-H
J8: PWR; PTSM-HH-2-RA
JP1, JP2: SolderJumper_3_Bridged12; SolderJumper3
L1: 470uH; L_4x4
L2: 47uH 1.3A; L_4x4_
P1, P7: +; SolderPadSmall
P2, P8: -; SolderPadSmall
P3, P4, P5, P6, P9, P10, P11, P12: 2; SolderPadSmall
PCB1: 70x70; PCB7070
Q1: BSS138; SOT-23
R1: 0.47R; R_0402
R2: 3R; R_0402
R3, R8: 10K; R_0402
R4, R5: 5k1; R_0402
R6, R7: 100R; R_0402
R9: 124k; R_0402_
R10: 39k2; R_0402_
R11: 1M; R_0402_
U3: MD8942; SOT-23-6-MD8942
U4: ESP32-S3-MINI-1
V1, V3, V4, V6: VCUT70N

Connections:
+3.3V: C2.1, C5.1, C11.1, C18.2, D4.2 (+), J1.15, J1.16, J2.3 (3V3), JP2.3 (B), L1.2, R3.1, U3.8 (VOUT), U4.3 (3V3)
BTN1: C19.1, R7.2, U4.32 (GPIO36)
BTN2: C21.1, R6.2, U4.33 (GPIO37)
BUSY: J1.9, J2.4 (Rx), U4.40 (GPIO44)
CLK: J1.13, U4.36 (GPIO40)
CS: J1.12, U4.37 (GPIO41)
D+: J3.3 (D+), J7.A6 (D+), J7.B6 (D+), U4.24 (GPIO20)
D-: J3.2 (D-), J7.A7 (D-), J7.B7 (D-), U4.23 (GPIO19)
DC: J1.11, U4.38 (GPIO42)
GND: C1.2, C2.2, C3.2, C4.2, C5.2, C6.2, C7.2, C11.2, C12.2, C14.2, C15.2, C18.1, C19.2, C21.2, D1.1 (K), D4.3 (-), D5.1, D7.1, J1.17, J1.25, J1.26, J2.1 (GND), J3.4 (GND), J4.1, J6.1, J7.A1 (GND), J7.A12 (GND), J7.B1 (GND), J7.B12 (GND), J7.S1 (SHIELD), J8.1, JP2.1 (A), P2.1, P4.1, P6.1, P8.1, P10.1, P12.1, R1.2, R2.1, R4.2, R5.2, R8.1, U3.2 (GND), U3.7 (GND), U4.1 (GND), U4.2 (GND), U4.31 (GPIO35), U4.42 (GND), U4.43 (GND), U4.46 (GND), U4.47 (GND), U4.48 (GND), U4.49 (GND), U4.50 (GND), U4.51 (GND), U4.52 (GND), U4.53 (GND), U4.54 (GND), U4.55 (GND), U4.56 (GND), U4.57 (GND), U4.58 (GND), U4.59 (GND), U4.60 (GND), U4.61 (GND), U4.62 (GND), U4.63 (GND), U4.64 (GND), U4.65 (GND)
MOSI: J1.14, U4.35 (GPIO39)
unnamed: C17.2, D1.2 (A), D2.1 (K)
unnamed: C14.1, D2.2 (A), J1.23
unnamed: C17.1, D3.2 (A), L1.1, Q1.3 (D)
unnamed: C15.1, D3.1 (K), J1.21
unnamed: J1.2, Q1.1 (G), R8.2
unnamed: J1.3, JP1.2 (C), Q1.2 (S)
unnamed: C12.1, J1.5
unnamed: J1.8, JP2.2 (C)
unnamed: C7.1, J1.18
unnamed: C4.1, J1.20
unnamed: C3.1, J1.22
unnamed: C1.1, J1.24
unnamed: J2.2 (0), U4.4 (GPIO0)
unnamed: D7.2, J4.2, P5.1, P11.1, R7.1
unnamed: D5.2, J6.2, P3.1, P9.1, R6.1
unnamed: J7.A5 (CC1), R4.1
unnamed: J7.B5 (CC2), R5.1
unnamed: JP1.1 (A), R2.2
unnamed: JP1.3 (B), R1.1
unnamed: C6.1, R3.2, U4.45 (EN)
PWR: D6.1 (K), J8.2, P1.1, P7.1, U3.5 (VIN)
RGB: D4.4 (I), U4.34 (GPIO38)
RST: J1.10, J2.5 (Tx), U4.39 (GPIO43)
VBUS: D6.2 (A), J3.1 (VBUS), J7.A4 (VBUS), J7.A9 (VBUS), J7.B4 (VBUS), J7.B9 (VBUS)
