revk/ESP32-EPD/PCB/EPD213/Epaper213.kicad_pcb

## KiCad design PCB/EPD213/Epaper213.kicad_pcb (2025-03-20)

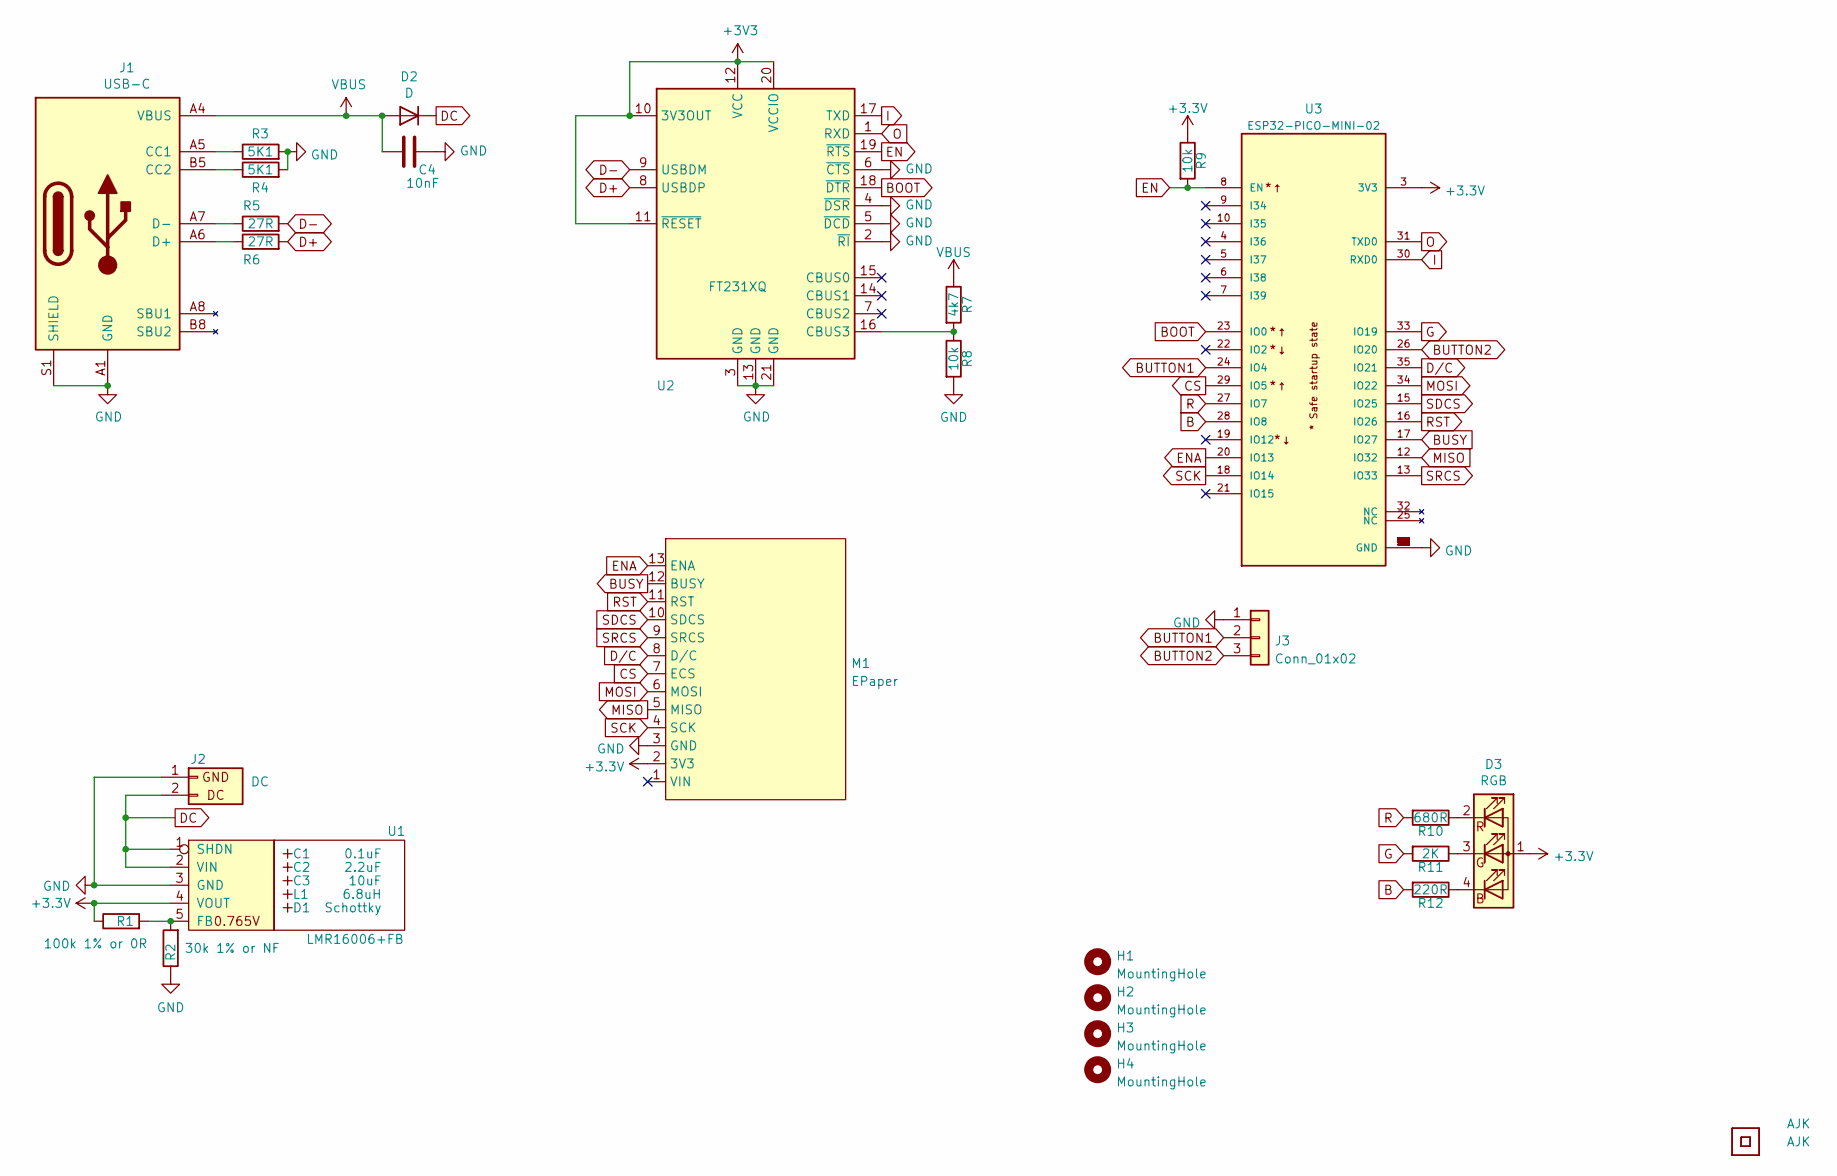
[picture p29: schematic Epaper213.kicad_sch, 2.13" epaper display board]

Parts:
C1: 0.1uF; Hidden
C2: 2.2uF; Hidden
C3: 10uF; Hidden
C4: 10nF; C_0603
D1: Schottky; Hidden; Part No CD1206-B2100
D2: D; D_1206
D3: RGB; LED-RGB-1.6x1.6
H1, H2, H3, H4: MountingHole; Hole-2.5mm
J1: USB-C; USC16-TR-Round
J2: DC; Molex_MiniSPOX_H2RA
J3: Conn_01x02; Molex_MiniSPOX_H3RA
L1: 6.8uH; Hidden; Part No TYA4020
Logo1, Logo2: AJK
M1: EPaper; PinHeader_1x13_P2.54mm_Vertical
R1: 100k 1% or 0R; R_0603
R2: 30k 1% or NF; R_0603
R3, R4: 5K1; R_0603
R5, R6: 27R; R_0603
R7: 4k7; R_0603
R8, R9: 10k; R_0603
R10: 680R; R_0603
R11: 2K; R_0603
R12: 220R; R_0603
U1: LMR16006+FB; RegulatorBlockFB; Part No LMR16006YQ3
U2: FT231XQ; QFN-20-1EP_4x4mm_P0.5mm_EP2.5x2.5mm
U3: ESP32-PICO-MINI-02; PARTREV v1.0
U4: QR; QR-GFX

Connections:
B: R12.2, U3.28 (IO8)
BOOT: U2.18 (~DTR), U3.23 (IO0)
BUSY: M1.12 (BUSY), U3.17 (IO27)
BUTTON1: J3.2, U3.24 (IO4)
BUTTON2: J3.3, U3.26 (IO20)
CS: M1.7 (ECS), U3.29 (IO5)
D+: R6.2, U2.8 (USBDP)
D-: R5.2, U2.9 (USBDM)
DC: D2.1 (K), J2.2 (DC), U1.1 (SHDN), U1.2 (VIN)
D/C: M1.8 (D/C), U3.35 (IO21)
EN: R9.2, U2.19 (~RTS), U3.8 (EN)
ENA: M1.13 (ENA), U3.20 (IO13)
G: R11.2, U3.33 (IO19)
GND: C4.1, J1.A1 (GND), J1.A12 (GND), J1.B1 (GND), J1.B12 (GND), J1.S1 (SHIELD), J2.1 (GND), J3.1, M1.3 (GND), R2.1, R3.2, R4.2, R8.2, U1.3 (GND), U2.2 (~RI), U2.3 (GND), U2.4 (~DSR), U2.5 (~DCD), U2.6 (~CTS), U2.13 (GND), U2.21 (GND), U3.1 (GND), U3.2 (GND), U3.11 (GND), U3.14 (GND), U3.36 (GND), U3.37 (GND), U3.38 (GND), U3.39 (GND), U3.40 (GND), U3.41 (GND), U3.42 (GND), U3.43 (GND), U3.44 (GND), U3.45 (GND), U3.46 (GND), U3.47 (GND), U3.48 (GND), U3.49 (GND), U3.50 (GND), U3.51 (GND), U3.52 (GND), U3.53 (GND)
I: U2.17 (TXD), U3.30 (RXD0)
MISO: M1.5 (MISO), U3.12 (IO32)
MOSI: M1.6 (MOSI), U3.34 (IO22)
unnamed: D3.2 (RK), R10.1
unnamed: D3.3 (GK), R11.1
unnamed: D3.4 (BK), R12.1
unnamed: J1.A5 (CC1), R3.1
unnamed: J1.A6 (D+), J1.B6 (D+), R6.1
unnamed: J1.A7 (D-), J1.B7 (D-), R5.1
unnamed: J1.B5 (CC2), R4.1
unnamed: R1.2, R2.2, U1.5 (FB)
unnamed: R7.2, R8.1, U2.16 (CBUS3)
O: U2.1 (RXD), U3.31 (TXD0)
R: R10.2, U3.27 (IO7)
RST: M1.11 (RST), U3.16 (IO26)
SCK: M1.4 (SCK), U3.18 (IO14)
SDCS: M1.10 (SDCS), U3.15 (IO25)
SRCS: M1.9 (SRCS), U3.13 (IO33)
VBUS: C4.2, D2.2 (A), J1.A4 (VBUS), J1.A9 (VBUS), J1.B4 (VBUS), J1.B9 (VBUS), R7.1

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
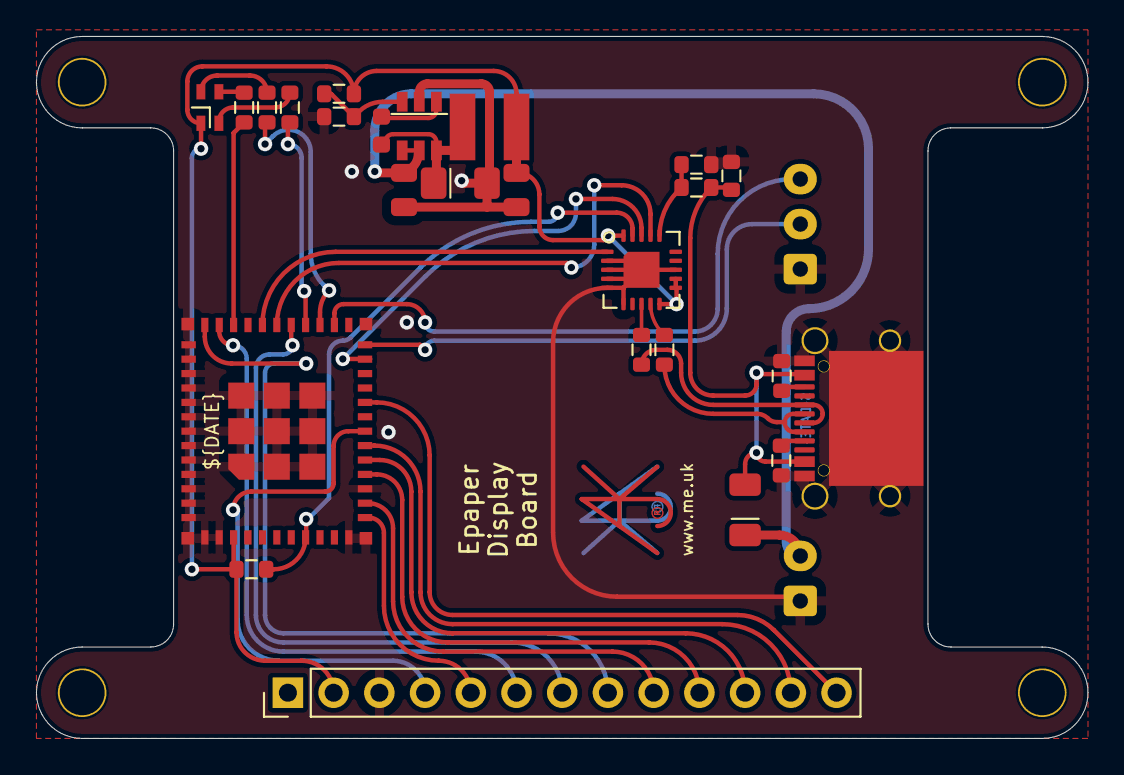
[picture p30: board Epaper213.kicad_pcb from above]

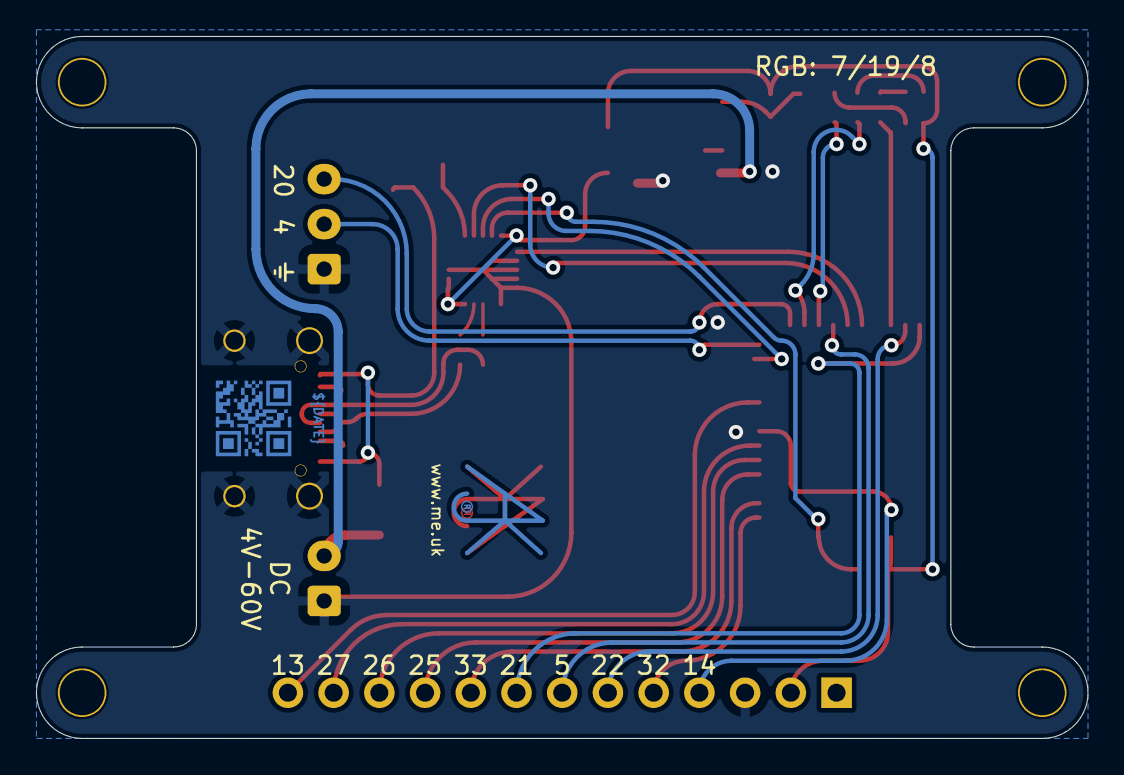
[picture p31: board Epaper213.kicad_pcb from below]

Board: 2 copper layers, 58.4 x 39.0 mm, 34 parts (2 on the bottom side), 34 nets.
