revk/ESP32-EPD/(commit log)

2025-02-25 Better, but mask not working
    [EPD.c]
2025-03-01 LEDs and alignment
2025-03-02 Tidy LEDs
2025-03-04 frame.png maybe
2025-03-04 raw frame
2025-03-04 Frame buffer as png
2025-03-06 Frame view flips
2025-03-08 LED task
2025-03-09 Fixn countdown for year 0000
    [EPD.c]
2025-03-12 Started on some SE MODBUS, but stalled
2025-03-12 SolarEdge option (overview/flow)
2025-03-13 Fix some edge cases
    [EPD.c]
2025-03-16 random flashing to try and clear burn in
    [EPD.c]
2025-03-17 Replaced $JSON with $MQTT1 to $MQTT5 allowing subscription to arbitrary topics with JSON payload
    [EPD.c]
2025-03-20 PCBs now here
    [Backbox-BodyPocket002.stl, Backbox.FCStd, EPD.kicad_pcb, EPD.kicad_sch, EPD.scad, EPD.stl, EPD75.kicad_sch, EPDBat.kicad_pcb]
2025-03-22 PCB updatep
    [EPD75.kicad_sch, bom.csv, designators.csv, positions.csv]
2025-03-24 Render and PCB tidy (inductors)
    [EPD75.kicad_pcb, EPD75.kicad_sch]
2025-03-26 Library update
    [EPD.kicad_sch, EPD75.kicad_pcb, EPD75.kicad_sch]
2025-03-27 Clear LEDS when clear
2025-03-28 Tidy for new inductor
    [EPD75.kicad_sch, bom.csv, designators.csv, positions.csv]
2025-03-29 LEDs on bins fix (again)
    [widget-bins.c]
2025-04-21 Misisng weather data some time, fixed
    [EPD.c]
2025-04-25 Various tweaks and correct pressure
    [EPD.c]
2025-05-04 Clean up sensors
2025-05-16 Fix TMP1075 offset (was backwards!)
    [EPD.c]
2025-05-16 PWM backlight
2025-05-16 Temperature colour override
2025-05-18 Started buttons
2025-05-18 More work on buttons
2025-05-18 Buttons in to HA now
2025-05-29 LED controls
2025-09-28 New LEDs
    [EPD75.kicad_pcb, EPD75.kicad_sch]
2025-09-28 Regulator update
    [EPD75.kicad_sch, bom.csv, designators.csv, positions.csv]
2025-09-28 SS fixes
    [EPD.scad, EPD.stl, EPDBat.scad, EPDBat.stl]
2025-11-01 Updated NFC, and re-render
    [EPD.scad, EPD.stl, EPD75.kicad_sch, EPDBat.scad, EPDBat.stl, bom.csv, designators.csv, positions.csv]
2025-11-01 ADded DS18B20
    [EPD75.kicad_sch, bom.csv, designators.csv, positions.csv]
